richardeoin/blackmagic-volt/README.md

Blackmagic Volt

## Details

* The programming connector is an ARM 10-PIN Interface as described
  [here](http://www.keil.com/support/man/docs/ulink2/ulink2_hw_connectors.htm).

## Parts

* [Parts List](Parts.md)

## License

* [License](LICENSE.md)
