richardeoin/blackmagic-volt/blackmagic_richardeoin.brd.png

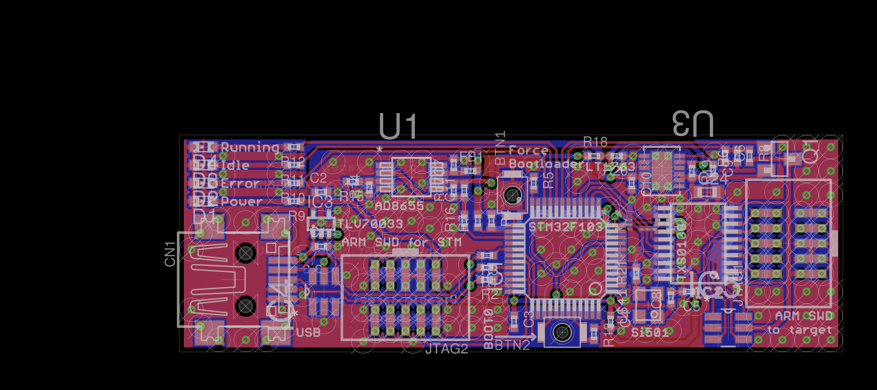
blackmagic_richardeoin.brd.png
