richardeoin/blackmagic-volt/blackmagic_richardeoin.sch.png

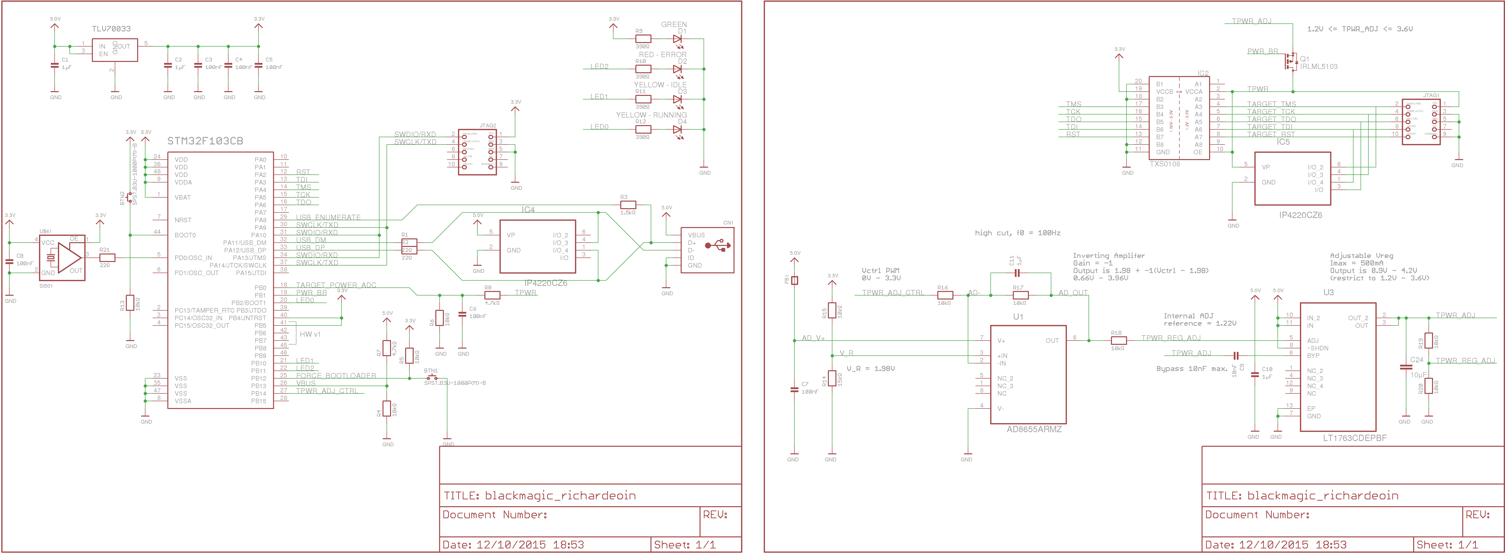
blackmagic_richardeoin.sch.png
