richardeoin/blackmagic-volt/Parts.md

# Parts List

| Part | Description | Supplier | Quantity Required | Notes
| ---  | --- | --- | --- | ---
|STM32F103CBT6|STMICROELECTRONICS - MCU, 32BIT, CORTEX-M3, 72MHZ, LQFP-48|[1606327](http://uk.farnell.com/webapp/wcs/stores/servlet/Search?st=1606327)|1|IC1 mcu, cortex m3
|20021121-00010C4LF.|FCI - Board-To-Board Connector, Right Angle, Minitek127 20021121 Series, Surface Mount, Header, 10|[1865279](http://uk.farnell.com/webapp/wcs/stores/servlet/Search?st=1865279)|2|JTAG1, JTAG2 arm swd connector 1.27mm
|10033526-N3212MLF|FCI - MINI USB, 2.0 TYPE B, PLUG, CABLE|[2112367](http://uk.farnell.com/webapp/wcs/stores/servlet/Search?st=2112367)|1|CN1 usb mini b. Note alignment pins on bottom are needed for hand placement
|B3U-1000P-B|OMRON ELECTRONIC COMPONENTS - SWITCH, SPST-NO, 0.05A, 12V, SMD, BOSS|[1333654](http://uk.farnell.com/webapp/wcs/stores/servlet/Search?st=1333654)|1|BTN1 spst tactile switch
|IRLML5103PBF|INTERNATIONAL RECTIFIER - MOSFET Transistor, P Channel, 610 mA, 30 V, 600 mohm, -10 V, -1 V|[8660085](http://uk.farnell.com/webapp/wcs/stores/servlet/Search?st=8660085)|1|Q1 p channel mosfet
|TXS0108EPWR|TEXAS INSTRUMENTS - TRANSLATOR, VOLTAGE, 8BIT, 20TSSOP|[1702548](http://uk.farnell.com/webapp/wcs/stores/servlet/Search?st=1702548)|1|IC2 voltage translator
|TLV70033DCKT|TEXAS INSTRUMENTS - IC, LDO, 200MA, 3.3V, 5SC70|[1815750](http://uk.farnell.com/webapp/wcs/stores/servlet/Search?st=1815750)|1|IC3 200mA 3.3v ldo
|IP4220CZ6,125|NXP - ESD Protection Device, 700 mV, SOT-457, 6|[1506629](http://uk.farnell.com/webapp/wcs/stores/servlet/Search?st=1506629)|2|IC4, IC5 usb esd protection, also swd esd protection
|AD8655ARMZ|ANALOG DEVICES - Operational Amplifier, Single, 28 MHz, 1, 11 V/Âµs, 2.7V to 5.5V, MSOP, 8|[2112576](http://uk.farnell.com/webapp/wcs/stores/servlet/Search?st=2112576)|1|IC6 rail-to-rail op amp AD8655
|LT1763IDE#PBF|LINEAR TECHNOLOGY - IC, LDO, ADJ, 0.5A, 12DFN|[1839216](http://uk.farnell.com/webapp/wcs/stores/servlet/Search?st=1839216)|1|IC7 LDO adj LT1763
|501ABA8M00000DAG|SILICON LABS - MEMS Oscillator, CMEMSÂ®, Si50x Series, 8 MHz, 30 ppm, 3.3 V, SMD, 2.5mm x 2mm, CMOS|[2394077](http://uk.farnell.com/webapp/wcs/stores/servlet/Search?st=2394077)|1|IC8 MEMS Osc. 8MHz

## Passives

| Part | Description | Supplier | Quantity Required | Notes
| ---  | --- | --- | --- | ---
|MC00625W0402122R|MULTICOMP - Surface Mount Chip Resistor, Thick Film, MC Series, 22 ohm, 62.5 mW, Â± 1%, 50 V, 0402 [1005 Metric]|[1357998](http://uk.farnell.com/webapp/wcs/stores/servlet/Search?st=1357998)|3|R1, R2, R3 22Ω
|MC00625W040211K5|MULTICOMP - Surface Mount Chip Resistor, Thick Film, MC Series, 1.5 kohm, 62.5 mW, Â± 1%, 50 V|[1358047](http://uk.farnell.com/webapp/wcs/stores/servlet/Search?st=1358047)|1|R4 1.5kΩ
|MC00625W040214K7|MULTICOMP - Surface Mount Chip Resistor, Thick Film, MC Series, 4.7 kohm, 62.5 mW, Â± 1%, 50 V|[1358060](http://uk.farnell.com/webapp/wcs/stores/servlet/Search?st=1358060)|2|R5, R6 4.7kΩ
|MC00625W0402110K|MULTICOMP - Surface Mount Chip Resistor, Thick Film, MC Series, 10 kohm, 62.5 mW, Â± 1%, 50 V|[1358069](http://uk.farnell.com/webapp/wcs/stores/servlet/Search?st=1358069)|10|R7, R8, R9, R10, R11, R12, R13, R14, R15, R16 10kΩ
|MC00625W0402115K|MULTICOMP - Surface Mount Chip Resistor, Thick Film, MC Series, 15 kohm, 62.5 mW, Â± 1%, 50 V|[1358073](http://uk.farnell.com/webapp/wcs/stores/servlet/Search?st=1358073)|1|R17 15kΩ
|MC00625W04021390R|MULTICOMP - Surface Mount Chip Resistor, Thick Film, MC Series, 390 ohm, 62.5 mW, Â± 1%, 50 V|[1358032](http://uk.farnell.com/webapp/wcs/stores/servlet/Search?st=1358032)|4|R18, R19, R20, R21 390Ω
|KPT-1608SGC|KINGBRIGHT - LED, GREEN, 12MCD, 568NM, 0603|[2099223](http://uk.farnell.com/webapp/wcs/stores/servlet/Search?st=2099223)|1|D1 green led
|KPT-1608EC|KINGBRIGHT - LED, 0603, RED, 15MCD, 625NM|[2099221](http://uk.farnell.com/webapp/wcs/stores/servlet/Search?st=2099221)|1|D2 red led
|KPT-1608YC|KINGBRIGHT - LED, 0603, YELLOW, 8MCD, 588NM|[2099227](http://uk.farnell.com/webapp/wcs/stores/servlet/Search?st=2099227)|2|D3, D4 yellow led
|GRM155R61E105KA12D|MURATA - SMD Multilayer Ceramic Capacitor, GRM Series, 1 ÂµF, Â± 10%, X5R, 25 V, 0402 [1005 Metric]|[2218855](http://uk.farnell.com/webapp/wcs/stores/servlet/Search?st=2218855)|2|C1, C2, C3, C4 1µF
|GRM155R71E103KA01D|MURATA - SMD Multilayer Ceramic Capacitor, GRM Series, 0.01 ÂµF, Â± 10%, X7R, 25 V, 0402 [1005 Metric]|[8819734](http://uk.farnell.com/webapp/wcs/stores/servlet/Search?st=8819734)|1|C5 10nF
|MC0402X104K100CT|MULTICOMP - SMD Multilayer Ceramic Capacitor, MC Series, 0.1 ÂµF, Â± 10%, X5R, 10 V, 0402 [1005 Metric]|[1759380](http://uk.farnell.com/webapp/wcs/stores/servlet/Search?st=1759380)|6|C6, C7, C8, C9, C10, C11 100nF
|06036D106MAT2A|AVX - SMD Multilayer Ceramic Capacitor, 10 ÂµF, Â± 20%, X5R, 6.3 V, 0603 [1608 Metric]|[1833804](http://uk.farnell.com/webapp/wcs/stores/servlet/Search?st=1833804)|1|C12 10µF 0603

## Useful items

| Part | Description | Supplier | Quantity Required | Notes
| ---  | --- | --- | --- | ---
|FFSD-05-D-06.00-01-N|SAMTEC - RIBBON CABLE, IDC, 152.4MM, GREY, 10WAY|[1667659](http://uk.farnell.com/webapp/wcs/stores/servlet/Search?st=1667659)|0|10way 1.27mm
