richardeoin/blackmagic-volt/blackmagic_richardeoin.sch.pdf

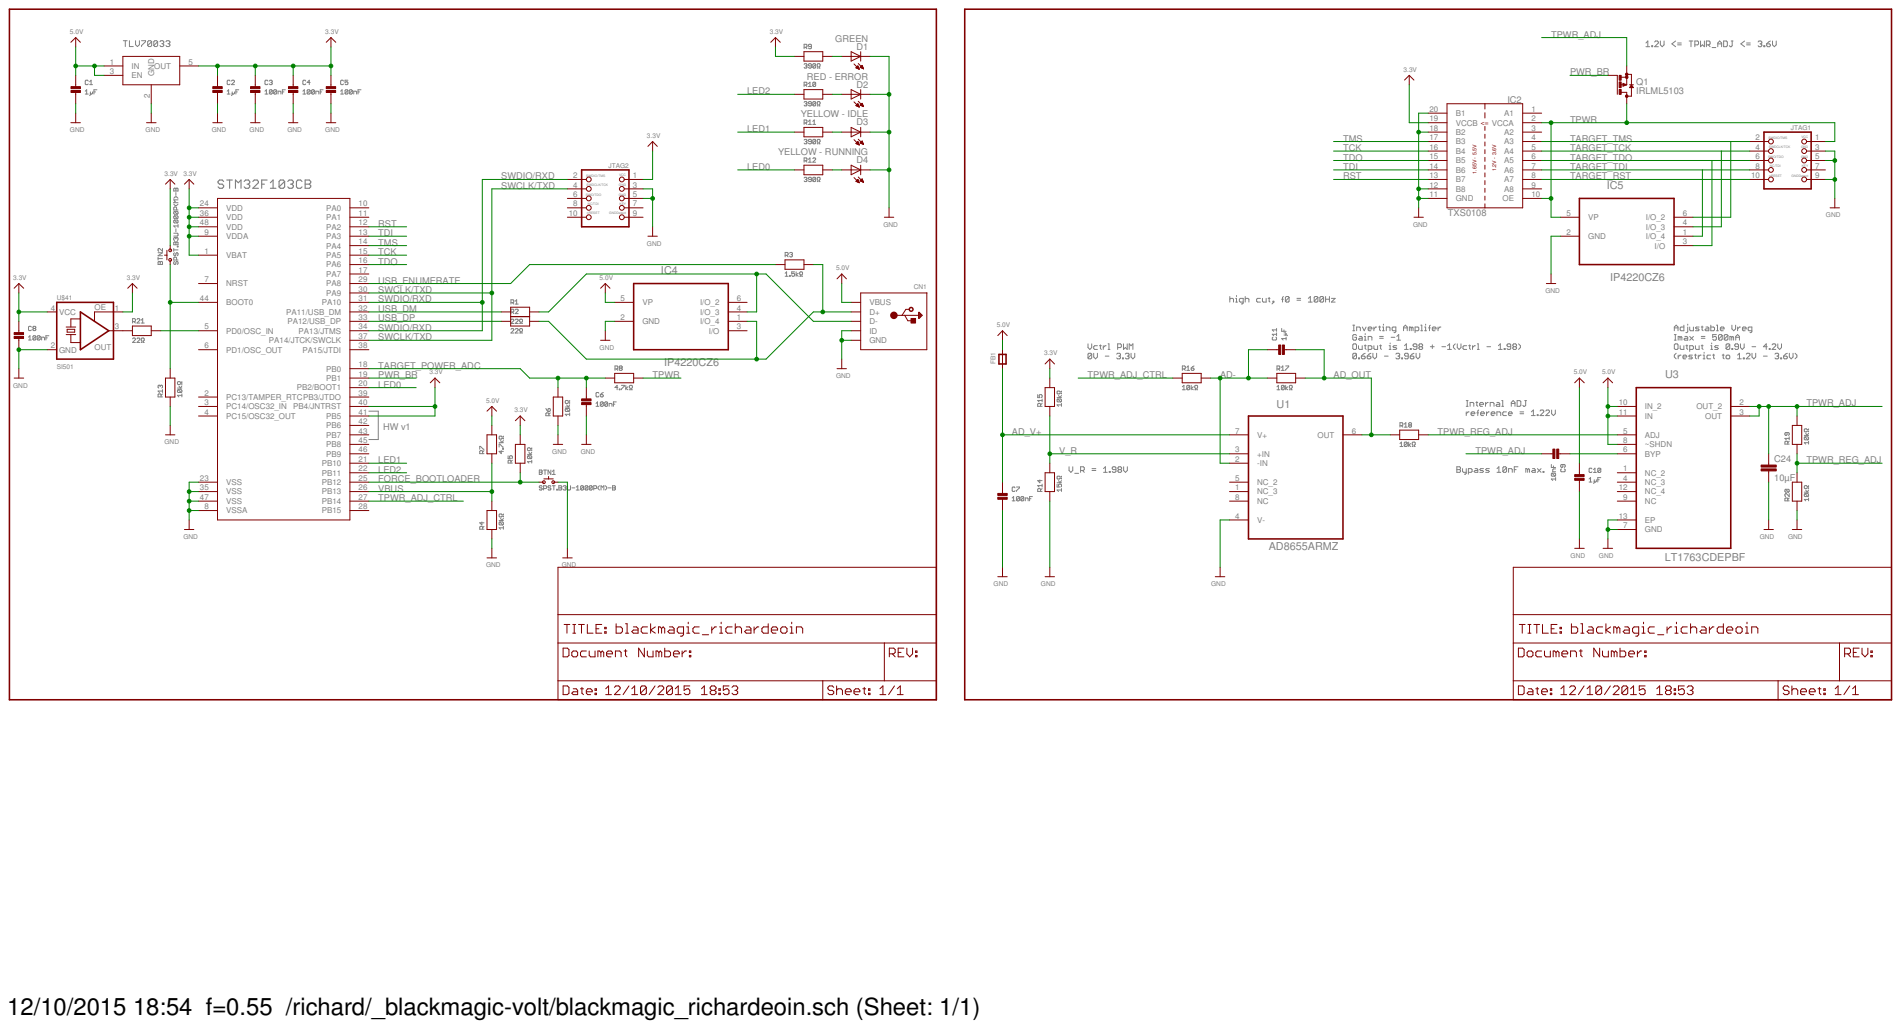
[picture p3: page 1]

TARGET_TDO

nRESET NC/TDI SWO/TDO

12/10/2015 18:54 f=0.55 /richard/_blackmagic-volt/blackmagic_richardeoin.sch (Sheet: 1/1)
