richardeoin/blackmagic-volt/blackmagic_richardeoin.brd.pdf

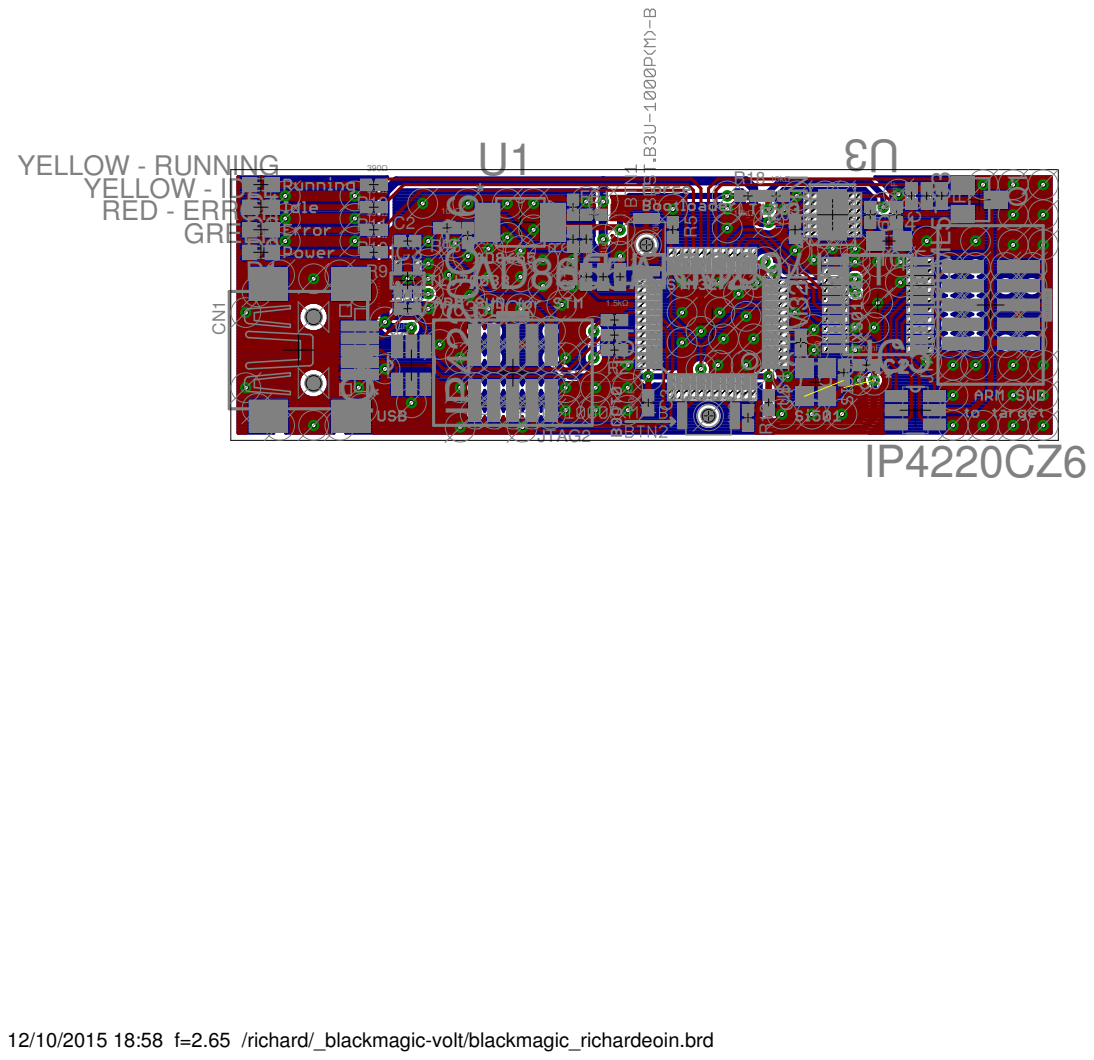
[picture p4: page 1]

R3
R1 | 100nF
