richardeoin/blackmagic-volt/blackmagic_richardeoin.brd

## EAGLE design blackmagic_richardeoin.brd (2015-10-12)

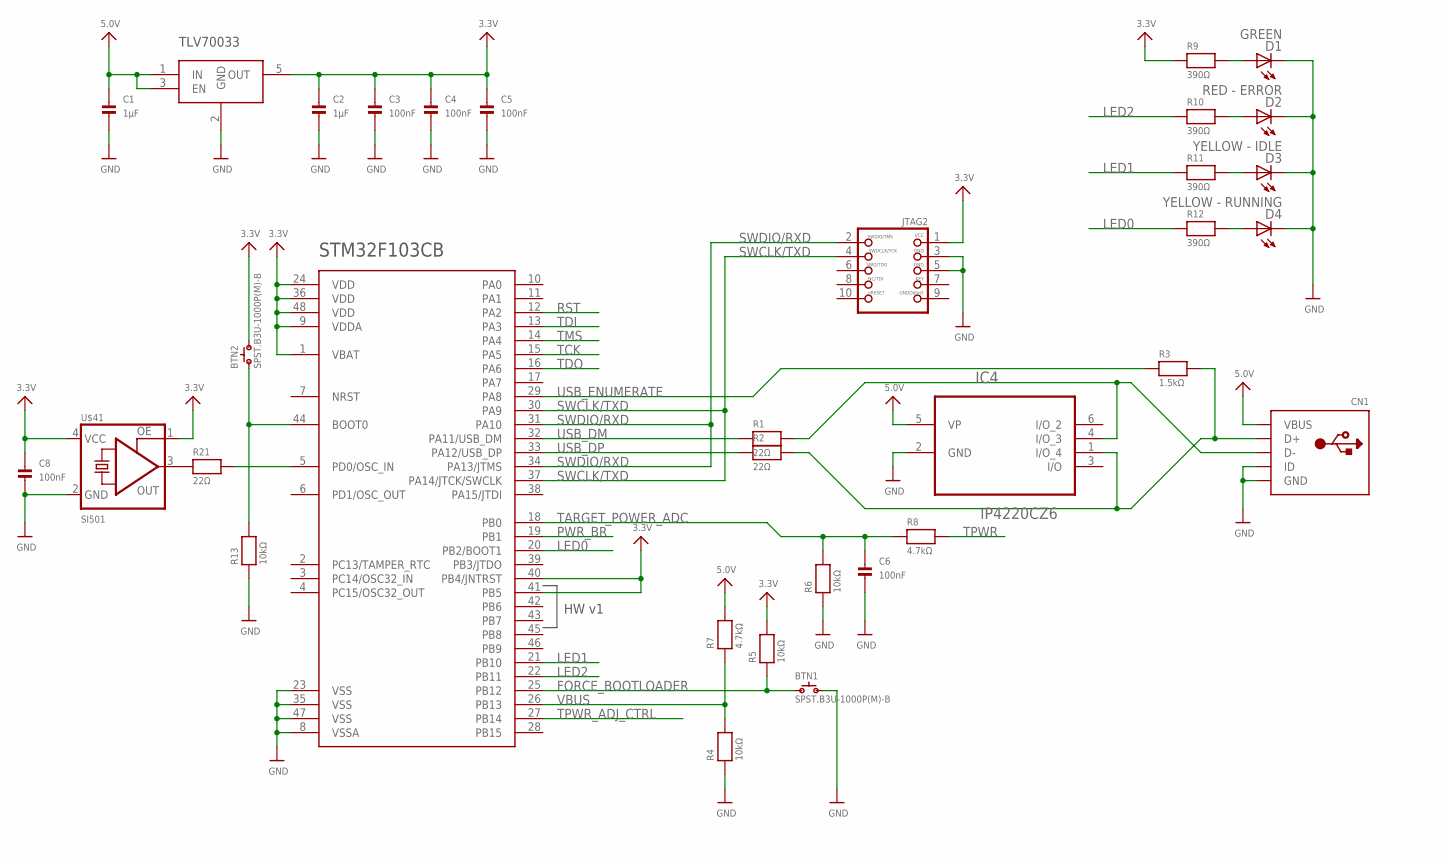
[picture p5: schematic blackmagic_richardeoin.sch, part in row 1, column 1]

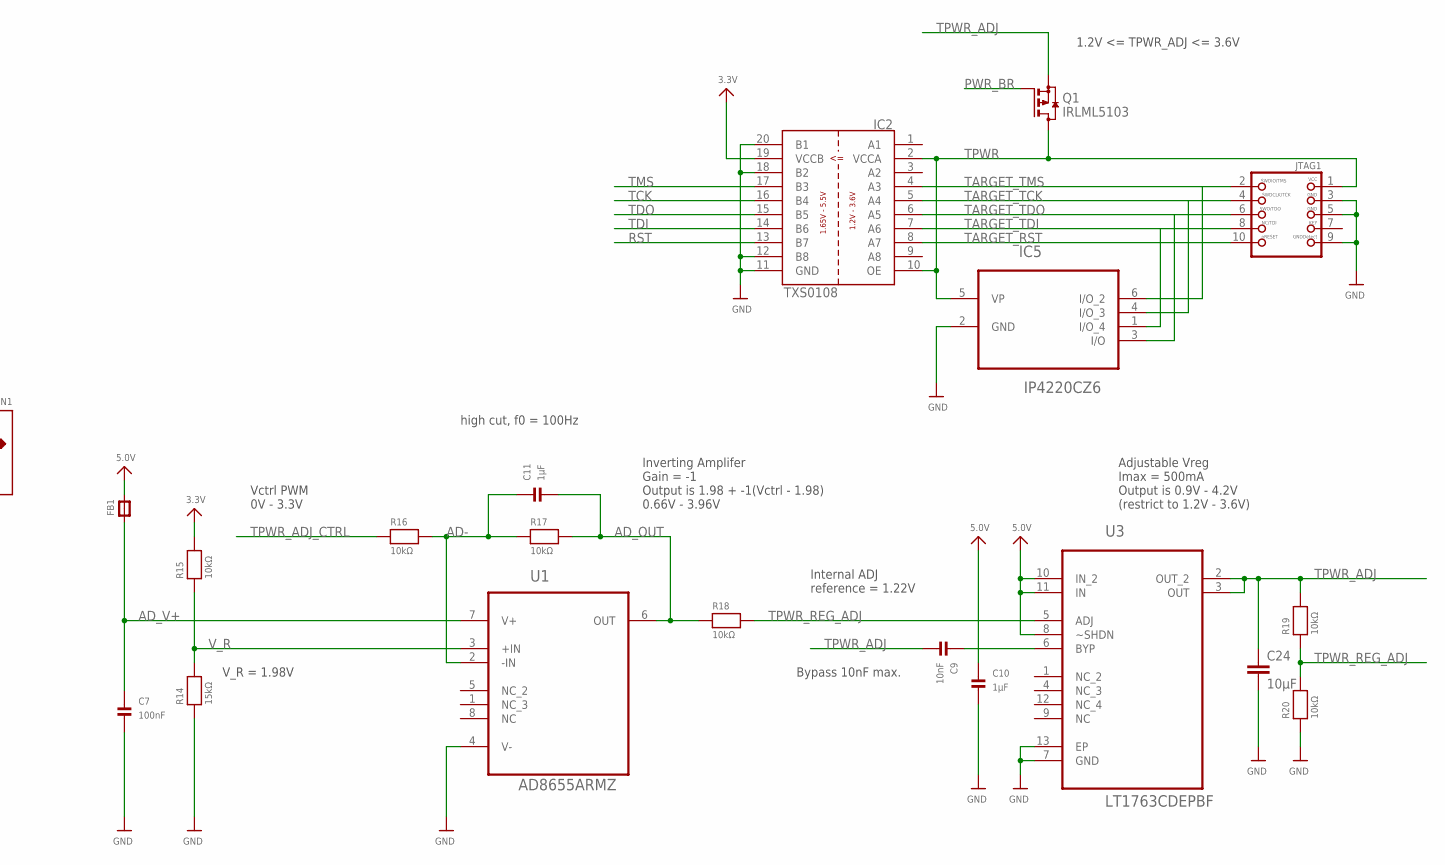
[picture p6: schematic blackmagic_richardeoin.sch, part in row 1, column 2]

Parts:
BTN1, BTN2: SPST.B3U-1000P(M)-B; B3U-1000P(M)-B
C1, C2, C10, C11: 1µF; _0402
C3, C4, C5, C6, C7, C8: 100nF; _0402
C9: 10nF; _0402
C24: 10µF; C0603K
CN1: USBMINIB; USB-MINIB
D1: GREEN; CHIPLED_0603
D2: RED - ERROR; CHIPLED_0603
D3: YELLOW - IDLE; CHIPLED_0603
D4: YELLOW - RUNNING; CHIPLED_0603
FB1: FERRITE_0402; _0402
IC1: STM32F_48PIN; TQFP48
IC2: TXS0108; TSSOP20
IC3: TLV70033DCK; SC70-5L
IC4, IC5: IP4220CZ6; SOT95P275X110-6N
JTAG1, JTAG2: JTAG-CORTEXM3; 2X05_1.27MM_SMT
Q1: IRLML5103; SOT23
R1, R2, R21: 22Ω; _0402
R3: 1.5kΩ; _0402
R4, R5, R6, R13, R15, R16, R17, R18, R19, R20: 10kΩ; _0402
R7, R8: 4.7kΩ; _0402
R9, R10, R11, R12: 390Ω; _0402
R14: 15kΩ; _0402
U1: AD8655ARMZ; SOP65P490X110-8N
U3: LT1763CDEPBF; DFN400X300X80-13N
U$41: SI501; SI501_2X2.5

Connections:
3.3V: BTN2.2, C2.1, C3.1, C4.1, C5.1, IC1.1 (VBAT), IC1.9 (VDDA), IC1.24 (VDD), IC1.36 (VDD), IC1.40 (PB4/JNTRST), IC1.41 (PB5), IC1.48 (VDD), IC2.19 (VCCB), IC3.5 (OUT), JTAG2.1, R5.2, R9.1, R15.2, U$41.1 (OE)
5.0V: C1.1, C10.1, CN1.VBUS, FB1.2, IC3.1 (IN), IC3.3 (EN), IC4.5 (VP), R7.2, U3.8 (~SHDN), U3.10 (IN_2), U3.11 (IN)
AD-: C11.1, R16.2, R17.1, U1.2 (-IN)
AD_OUT: C11.2, R17.2, R18.1, U1.6 (OUT)
AD_V+: C7.1, FB1.1, U1.7 (V+)
BOOT0: BTN2.1, IC1.44 (BOOT0), R13.2
FORCE_BOOTLOADER: BTN1.1, IC1.25 (PB12), R5.1
GND: BTN1.2, C1.2, C2.2, C3.2, C4.2, C5.2, C6.2, C7.2, C8.2, C10.2, C24.2, CN1.GND, CN1.ID, D1.C, D2.C, D3.C, D4.C, IC1.8 (VSSA), IC1.23 (VSS), IC1.35 (VSS), IC1.47 (VSS), IC2.11 (GND), IC2.12 (B8), IC2.18 (B2), IC2.20 (B1), IC3.2 (GND), IC4.2 (GND), IC5.2 (GND), JTAG1.3, JTAG1.5, JTAG1.9, JTAG2.3, JTAG2.5, R4.1, R6.1, R13.1, R14.1, R20.1, U1.4 (V-), U3.7 (GND), U3.13 (EP), U$41.2 (GND)
IC8: C8.1, U$41.4 (VCC)
LED0: IC1.20 (PB2/BOOT1), R12.1
LED0_R: D4.A, R12.2
LED1: IC1.21 (PB10), R11.1
LED1_R: D3.A, R11.2
LED2: IC1.22 (PB11), R10.1
LED2_R: D2.A, R10.2
LED3_R: D1.A, R9.2
unnamed: IC1.5 (PD0/OSC_IN), R21.2
unnamed: R21.1, U$41.3 (OUT)
PWR_BR: IC1.19 (PB1), Q1.1 (G)
RST: IC1.12 (PA2), IC2.13 (B7)
SWCLK/TXD: IC1.30 (PA9), IC1.37 (PA14/JTCK/SWCLK), JTAG2.4
SWDIO/RXD: IC1.31 (PA10), IC1.34 (PA13/JTMS), JTAG2.2
TARGET_POWER_ADC: C6.1, IC1.18 (PB0), R6.2, R8.1
TARGET_RST: IC2.8 (A7), JTAG1.10
TARGET_TCK: IC2.5 (A4), IC5.4 (I/O_3), JTAG1.4
TARGET_TDI: IC2.7 (A6), IC5.1 (I/O_4), JTAG1.8
TARGET_TDO: IC2.6 (A5), IC5.3 (I/O), JTAG1.6
TARGET_TMS: IC2.4 (A3), IC5.6 (I/O_2), JTAG1.2
TCK: IC1.15 (PA5), IC2.16 (B4)
TDI: IC1.13 (PA3), IC2.14 (B6)
TDO: IC1.16 (PA6), IC2.15 (B5)
TMS: IC1.14 (PA4), IC2.17 (B3)
TPWR: IC2.2 (VCCA), IC2.10 (OE), IC5.5 (VP), JTAG1.1, Q1.3 (D), R8.2
TPWR_ADJ: C9.2, C24.1, Q1.2 (S), R19.2, U3.2 (OUT_2), U3.3 (OUT)
TPWR_ADJ_CTRL: IC1.27 (PB14), R16.1
TPWR_REG_ADJ: R18.2, R19.1, R20.2, U3.5 (ADJ)
TPWR_REG_BYP: C9.1, U3.6 (BYP)
USB_D+: CN1.D+, IC4.1 (I/O_4), R2.2, R3.2
USB_D-: CN1.D-, IC4.4 (I/O_3), R1.2
USB_DM: IC1.32 (PA11/USB_DM), R1.1
USB_DP: IC1.33 (PA12/USB_DP), R2.1
USB_ENUMERATE: IC1.29 (PA8), R3.1
VBUS: IC1.26 (PB13), R4.2, R7.1
V_R: R14.2, R15.1, U1.3 (+IN)

Notes on the sheet:
STM32F103CB
HW v1
TLV70033
1.2V <= TPWR_ADJ <= 3.6V
V_R = 1.98V
high cut, f0 = 100Hz
Internal ADJ reference = 1.22V
Bypass 10nF max.
Inverting Amplifer Gain = -1 Output is 1.98 + -1(Vctrl - 1.98) 0.66V - 3.96V
Vctrl PWM 0V - 3.3V
Adjustable Vreg Imax = 500mA Output is 0.9V - 4.2V (restrict to 1.2V - 3.6V)

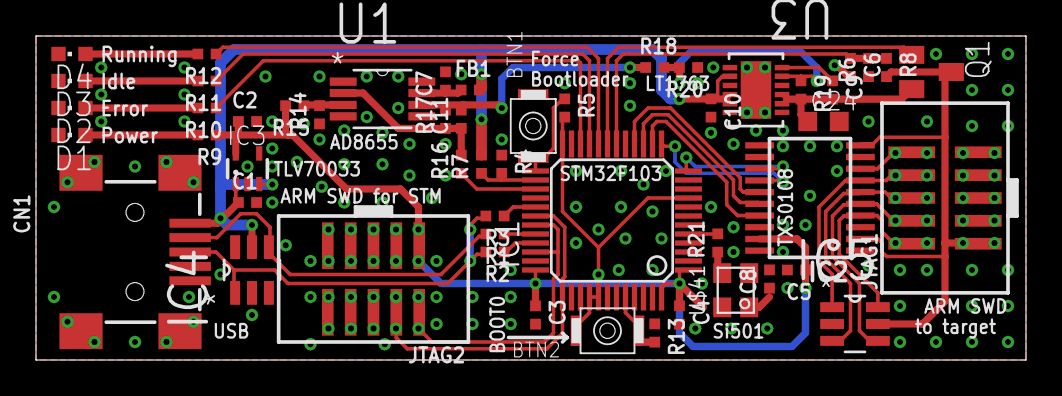
[picture p7: board blackmagic_richardeoin.brd from above]

Board: 2 copper layers, 55.0 x 18.0 mm, 52 parts (0 on the bottom side), 44 nets.
