richardeoin/blackmagic-volt/(commit log)

2015-10-12 Inital commit
    [blackmagic_richardeoin.brd, blackmagic_richardeoin.sch]
2015-10-12 Update parts list with 2x esd, split passives into separte list for clarity
    [blackmagic_richardeoin.brd, blackmagic_richardeoin.sch]
