richardeoin/blackmagic-volt/(notices)

Notices in the files:
parts and their libraries:
microbuilder_v3: This work is placed in the public domain, and may be freely used for commercial and non-commercial work with the following conditions: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
SparkFun: Licensing: CC v3.0 Share-Alike You are welcome to use this library for commercial purposes.
